ieb/FlowSensor/design/double-ntc-explorer/ltspice/doublentc_ctd_components.asc

Bloss: bi; I=(V(Tdn)-V(Tfl))*V(Gf)
Bqh: bi; I=I(Rheat)*I(Rheat)*3.6
Bsaw: bv; V=(time*1k)-floor(time*1k)
Cel: cap; 1.6
Cf: cap; 47u
Cflt: cap; 4.7u
Chs: cap; 2
Dza: diode; DZ
Dzb: diode; DZ
MN1: nmos; PWRFET
Ra: res; 6.41k
Rb: res; 10k
Rcond: res; 3
Rdn: res; R=10000*exp(3950*(1/(V(Tdn)+273.15)-1/298.15))
Rf_n: res; 10Meg
Rf_p: res; 10Meg
Rflt: res; 10k
Rfpp: res; 200k
Rg: res; 100
Rheat: res; 3.6
Rin_n: res; 1Meg
Rin_p: res; 1Meg
Rip: res; 100k
Rsa1: res; 1k
Rsa2: res; 9k
Rsense: res; 0.1
Rup: res; R=10000*exp(3950*(1/(V(Tfl)+273.15)-1/298.15))
U1: opamp2; OPAMP
U2: opamp2; OPAMP
U3: opamp2; OPAMP
U4: opamp2; OPAMP
Vcc: voltage; 12
Vee: voltage; -12
Vfl: voltage; 20
Vg: voltage; PWL(0 1.0 17.999 1.0 18 1.746)
Vpwr: voltage; 12
Vx: voltage; 5
Named nets: vcc, 0, vee, vpwr, vexc, Tfl, Gf, nodeL, nodeR, uA_n, err, uA_p, pi_n, pmid, vctrl, zc, navg, sa_n, vadc, saw, pwm, gate, nd, nsrc, Th, Tdn
.subckt OPAMP inp inn vcc vee out
Gm 0 n1 inp inn 100k
R1 n1 0 1
C1 n1 0 1.5915m
Bo nob 0 V=if(V(n1)>V(vcc)-1.2,V(vcc)-1.2,if(V(n1)<V(vee)+1.2,V(vee)+1.2,V(n1)))
Rout nob out 100
.ends
.model DZ D(Is=1e-12 BV=0.9 Ibv=10m)
.model PWRFET VDMOS(Vto=2.5 Kp=20 Rd=0.02 Cgs=1n Cgdmax=0.5n Cgdmin=0.05n)
.ic V(Tdn)=20 V(Th)=20 V(vctrl)=0
.tran 0 30 0 30u uic
DoubleNTC CTD flow sensor -- component-level model (mirrors doublentc_ctd_components.cir)
