ieb/FlowSensor/(commit log)

2026-06-15 pcb, device and firmware
    [esp32c-flowsensor.kicad_pcb, esp32c-flowsensor.kicad_sch, no_ota.csv, wateresensor.scad]
2026-06-18 Pcb update
    [esp32c-flowsensor.kicad_pcb, esp32c-flowsensor.kicad_sch]
2026-06-23 Stopping work in favour of exhaust elbow sensing
    [esp32c-flowsensor.kicad_pcb, esp32c-flowsensor.kicad_sch]
2026-06-23 added pcb2gcode script
